JBaker101/Automatic-Wiper/README.md

Review "Project Details" for detailed project information.
